herzlichtechnology/Gabor/washer.stl

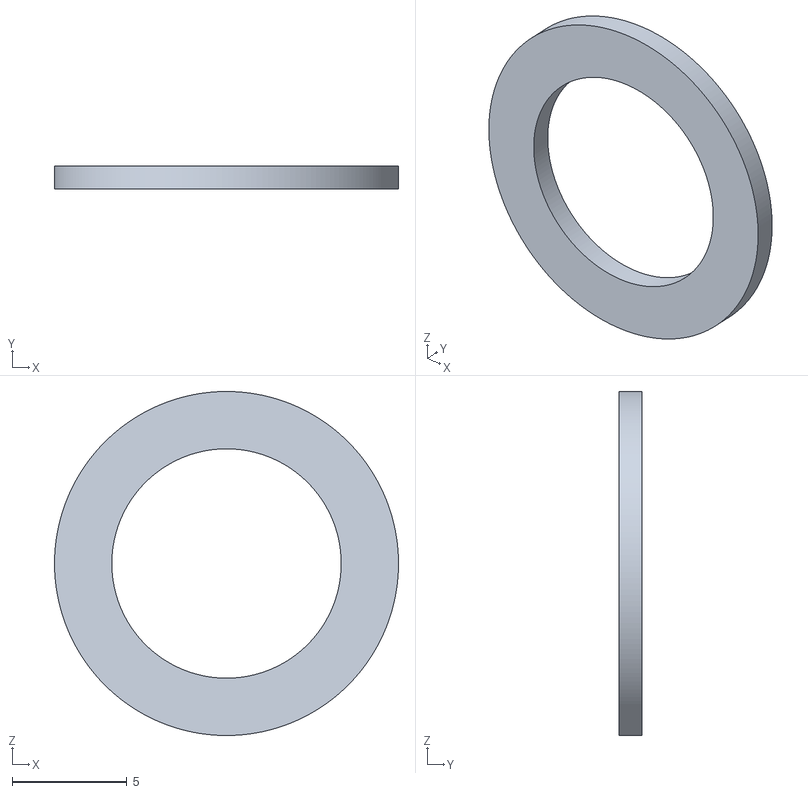
[picture p3: CAD file, 2022-11-03]
washer.stl
15.0 x 1.00 x 15.0
